autouav/finalproject/Reports/rep4/עמוד שער.docx

נווט אוטונומי

אוניברסיטת אריאל | http://www.ariel.ac.il/research/kcg

מנחה הפרויקט: ד"ר בועז בן משה

מגישים: נאור ידעי (302568894) יוסף זוהר (021512884)

אתר הפרויקט: https://github.com/autouav/finalproject

‏2015

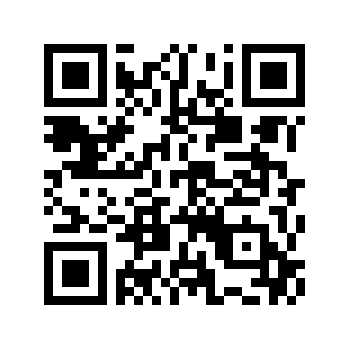
[picture p60: figure]
