autouav/finalproject/Reports/rep4/תרשים.docx

תרשים מס' 1: תרשים זה מתאר את המזל"ט בתחילת התהליך: המזל"ט במצב "קרקע". לאחר בדיקת תקינות המזל"ט עובר למצב "המתנה". הריבוע המסומן באדום הינו מעבר לתרשימים הבאים (2-3)

הפעלת
המזל"ט
חיבור המערכות:
Wifi, Bluetooth
ובדיקת תקינות
קיימת בעיה
מופיעה הודעה מתאימה על מסך הטלפון החכם
המערכת תקינה
ומחוברת כראוי
המזל"ט עולה לאוויר ובודק אם קיימת מטרה אחת או יותר
דוגמאות לבעיה:
בטריה חלשה
אין חיבור למטוס
לא התקבלה מטרה
המזל"ט נוחת במקום
התקבלה מטרה
המזל"ט מתכוונן אל המטרה בעזרת ומתחיל בנסיעה בקו ישר אל היעד

תרשים מס' 2: תרשים זה מתאר את המצב "טיסה אל היעד", בהנחה שלא קיימים מכשולים בין נקודת המוצא לבין נקודת היעד.

חשוב לשים לב: ייתכן שבשלב ראשון לא יהיו מכשולים בדרך, ולכן נעבוד לפי תרשים זה. אך בהמשך התרשים ישנם מצבים המחזירים אותנו לשלב "התקבלה מטרה", ושלב זה מתפצל לשניים: ללא מכשולים (תרשים זה), ועם מכשולים (תרשים 3, מובא להלן).

התקבלה מטרה
המזל"ט מתכוונן אל המטרה בעזרת ומתחיל בנסיעה בקו ישר אל היעד
אין מכשול
המזל"ט ממשיך בטיסה ישירה אל היעד
המזל"ט הגיע אל היעד
ממתין 5 שניות
המזל"ט לא הגיע אל היעד
תוך זמן קצוב ביחס למטרה
האלגוריתם יחזור לשלב
"התקבלה מטרה"
התקבלה מטרה נוספת
האלגוריתם יחזור לשלב
"התקבלה מטרה"
לא התקבלה מטרה נוספת
המטוס נוחת בנקודה

תרשים מס' 3: תרשים זה מתאר את המצב "סכנה" (מיידית / לא מיידית), ואת המצב "התגברות על מכשול".

חשוב לשים לב: ייתכן שבשלב ראשון נגיע למכשול, ולכן נעבוד לפי תרשים זה. אך בהמשך התרשים ישנם מצבים המחזירים אותנו לשלב "התקבלה מטרה", ושלב זה מתפצל לשניים: כולל מכשולים (תרשים זה), וללא מכשולים (תרשים 2, הובא לעיל).

התקבלה מטרה
המזל"ט מתכוונן אל המטרה בעזרת ומתחיל בנסיעה בקו ישר אל היעד
המטוס מתקרב למכשול
סכנה לא מיידית
המזל"ט עובר למצב
"עקיפת מכשול"
סכנה מיידית
המזל"ט נסוג לאחור
וממשיך באלגוריתם של
"סכנה לא מיידית"
אין מכשול
האלגוריתם יחזור לשלב
"התקבלה מטרה"
כל עוד קיים מכשול
המזל"ט טס ימינה ומשפר זווית ביחס למטרה עד שהמכשול נעלם מהסנסור הקידמי וממשיך באלגוריתם של "אין מכשול"
