autouav/finalproject/Reports/rep4/1.Still001.png

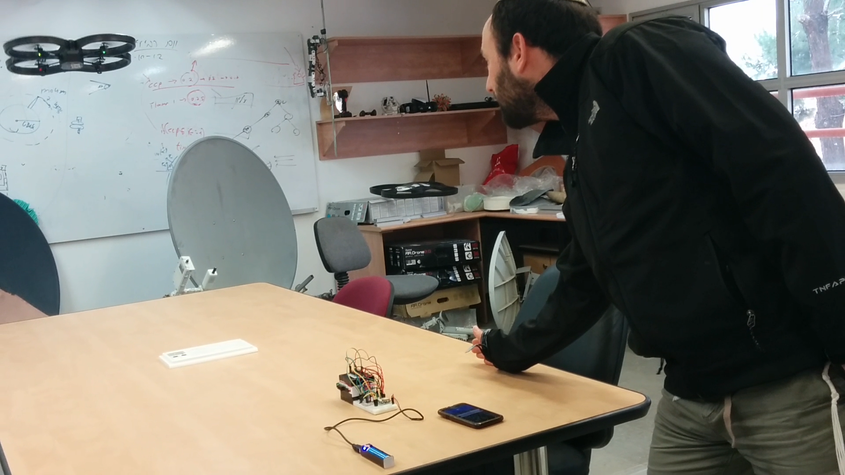
Reports/rep4/1.Still001.png
