autouav/finalproject/Reports/rep4/1.Still002.png

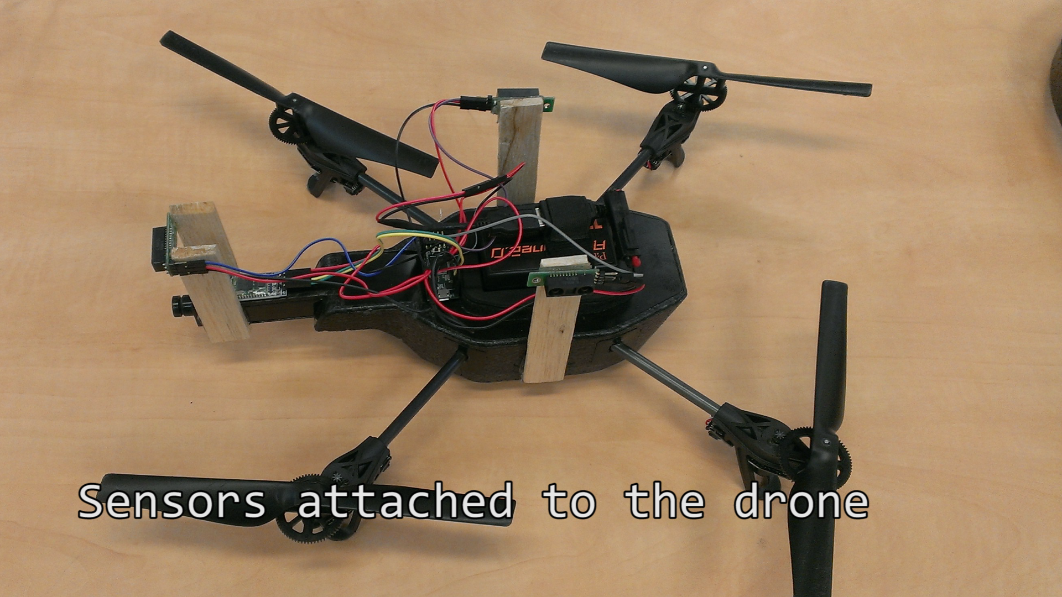
Reports/rep4/1.Still002.png
