autouav/finalproject/Reports/rep4/1.Still004.png

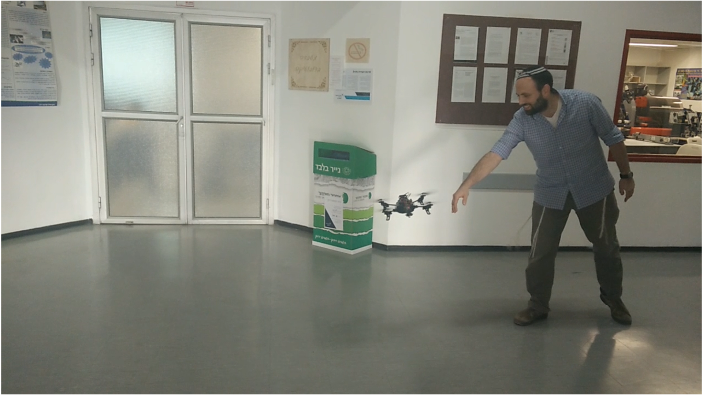
Reports/rep4/1.Still004.png
