autouav/finalproject/Reports/rep4/1.Still005.png

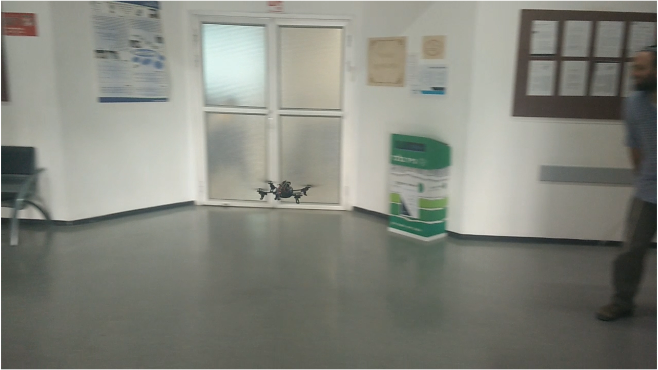
Reports/rep4/1.Still005.png
