autouav/finalproject/Reports/rep4/1.Still006.png

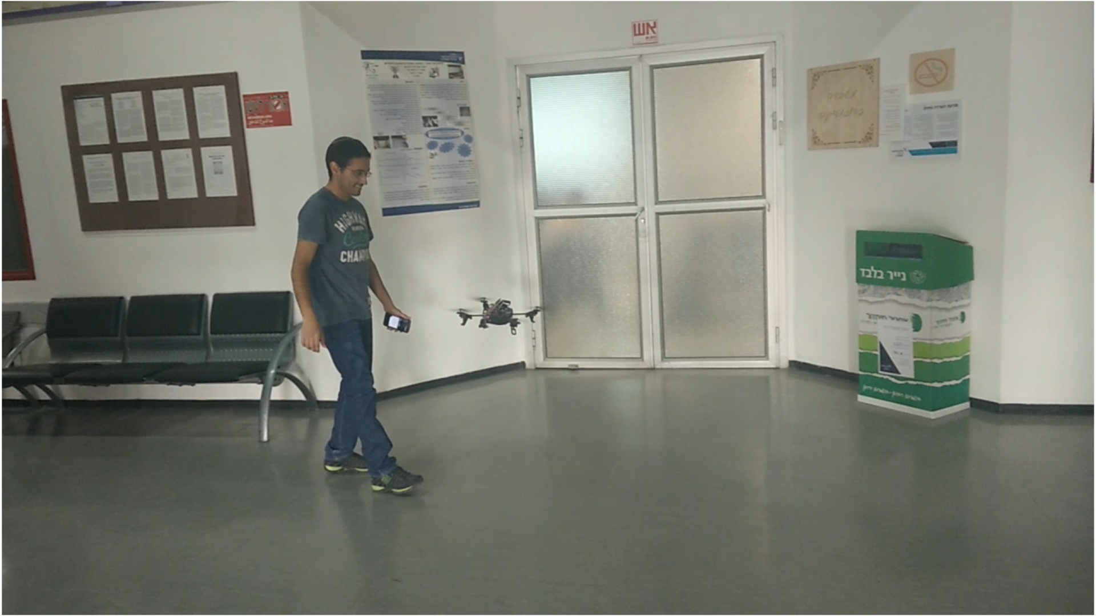
Reports/rep4/1.Still006.png
