autouav/finalproject/Reports/rep4/1.Still007.png

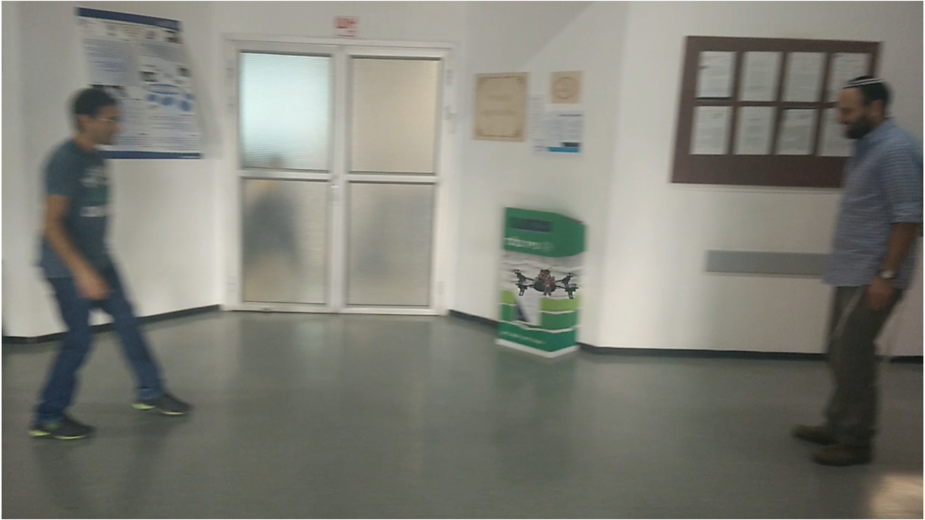
Reports/rep4/1.Still007.png
