autouav/finalproject/Reports/rep4/1.Still008.png

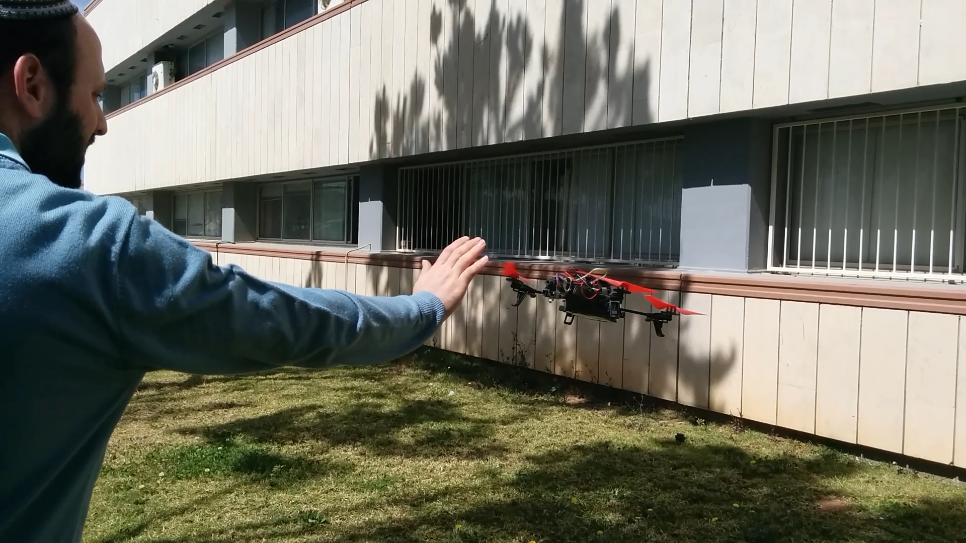
Reports/rep4/1.Still008.png
