autouav/finalproject/Reports/rep4/1.Still009.png

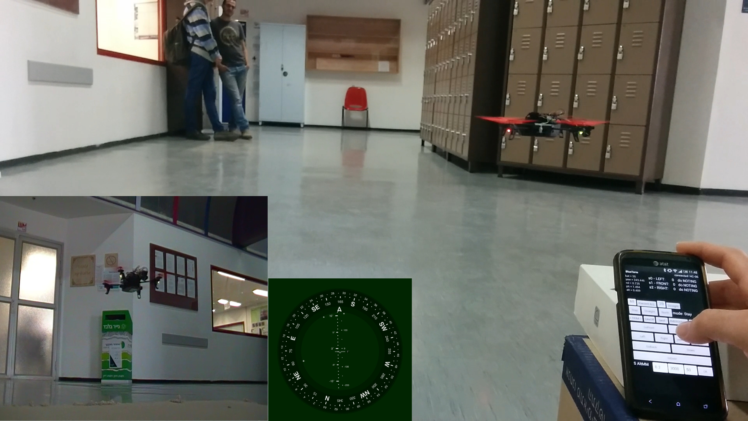
Reports/rep4/1.Still009.png
