autouav/finalproject/Reports/rep4/1.Still010.png

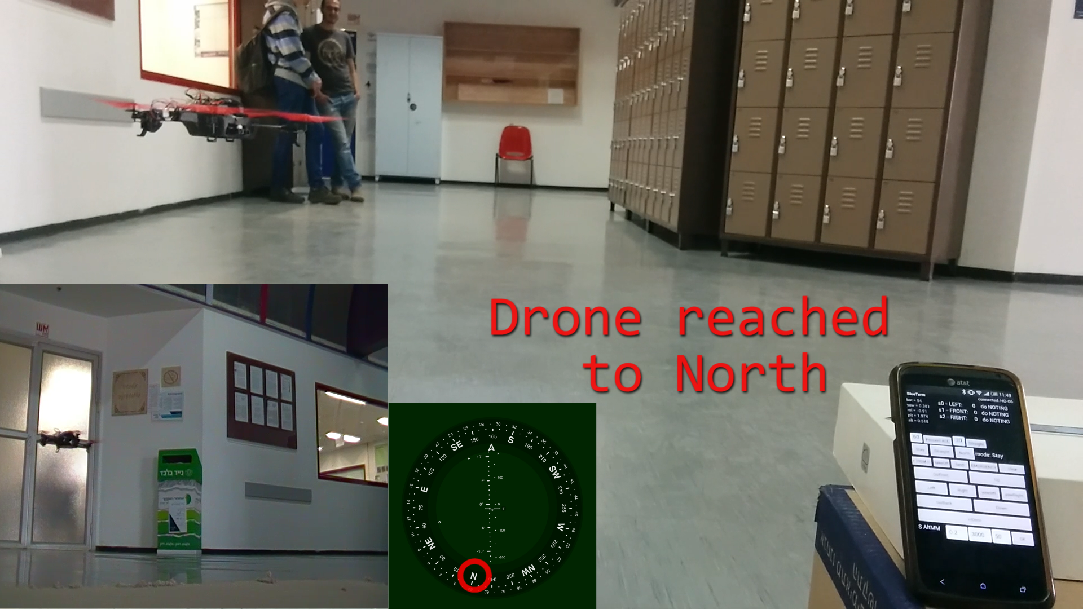
Reports/rep4/1.Still010.png
