autouav/finalproject/Reports/rep4/diagram2_bb.jpg

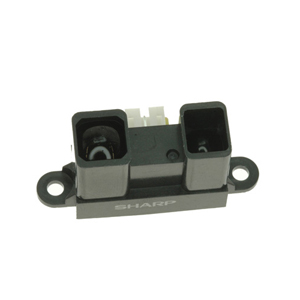
Reports/rep4/diagram2_bb.jpg
