autouav/finalproject/Reports/rep4/diagram.jpg

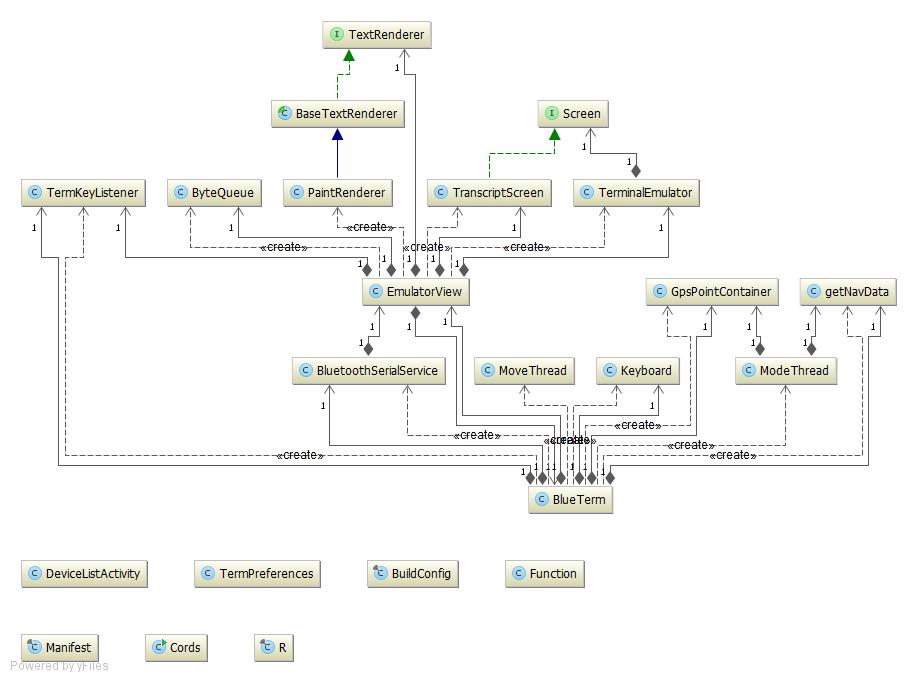
Reports/rep4/diagram.jpg
