autouav/finalproject/Reports/rep4/drone.jpg

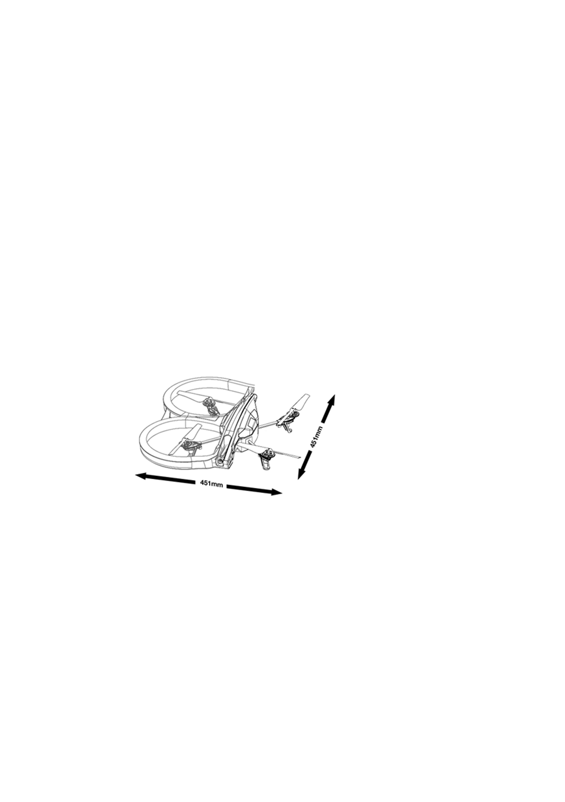
Reports/rep4/drone.jpg
