autouav/finalproject/Reports/rep4/Gyro.jpg

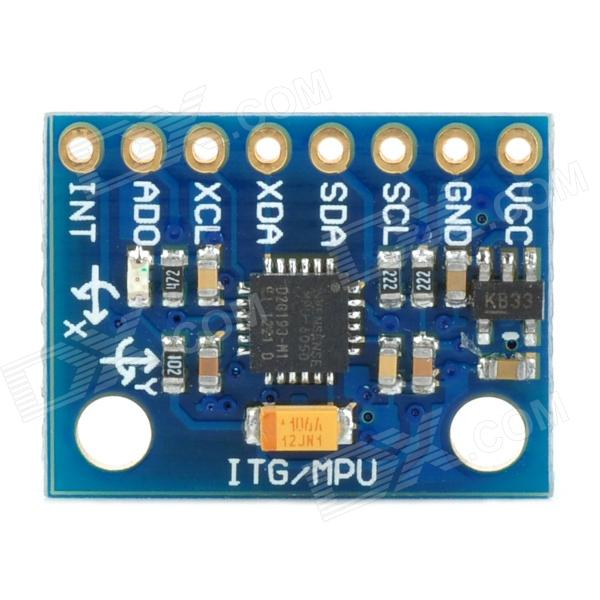
Reports/rep4/Gyro.jpg
