autouav/finalproject/Reports/rep4/IMG_20150111_101517.jpg

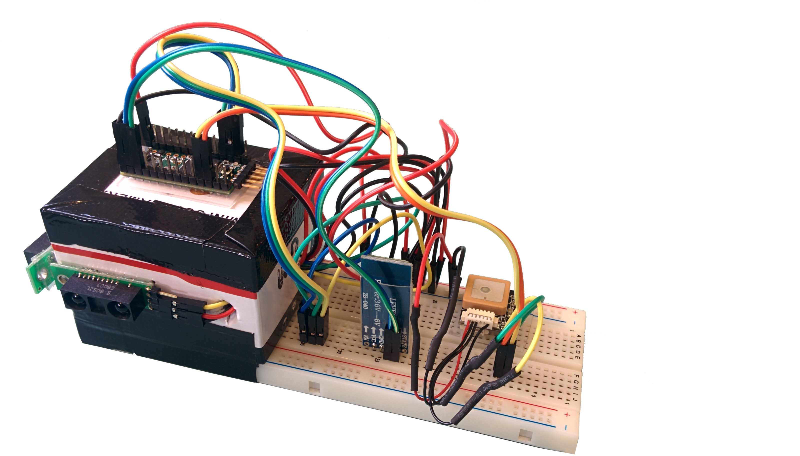
Reports/rep4/IMG_20150111_101517.jpg
