autouav/finalproject/Reports/rep4/Screenshot_2015-07-21-11-58-32.png

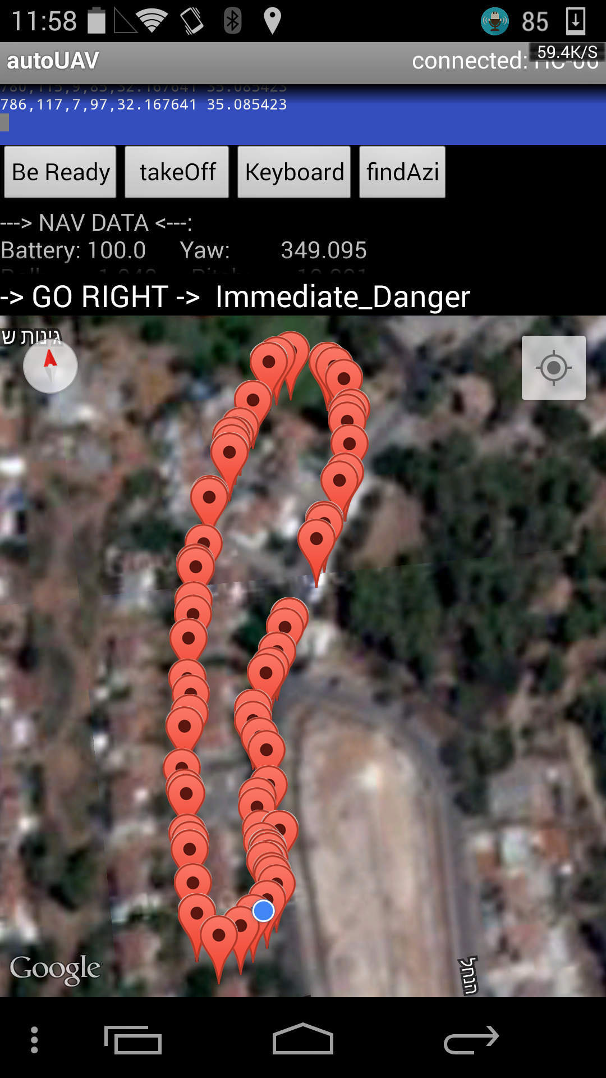
Reports/rep4/Screenshot_2015-07-21-11-58-32.png
