autouav/finalproject/Reports/rep4/Screenshot_2015-08-09-10-08-52.png

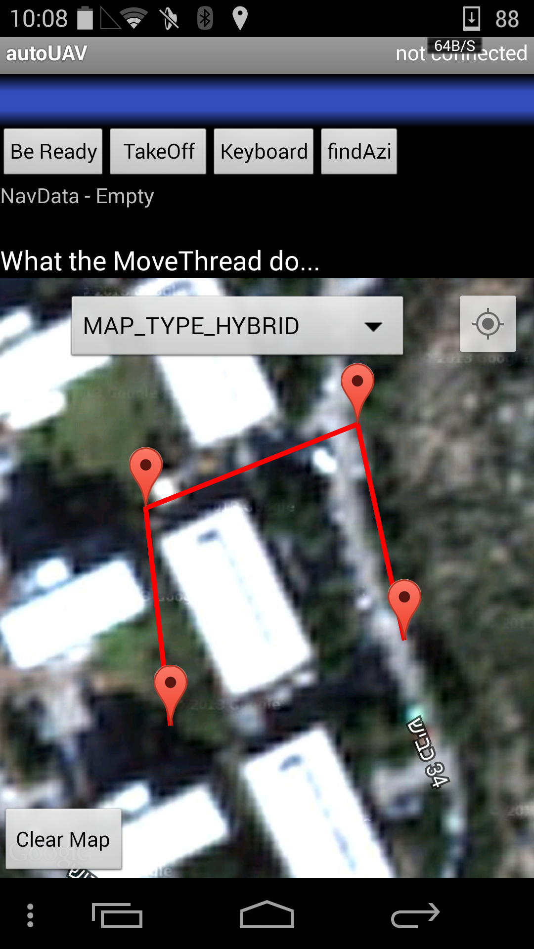
Reports/rep4/Screenshot_2015-08-09-10-08-52.png
