autouav/finalproject/Reports/rep4/Screenshot_2015-08-16-12-53-28.png

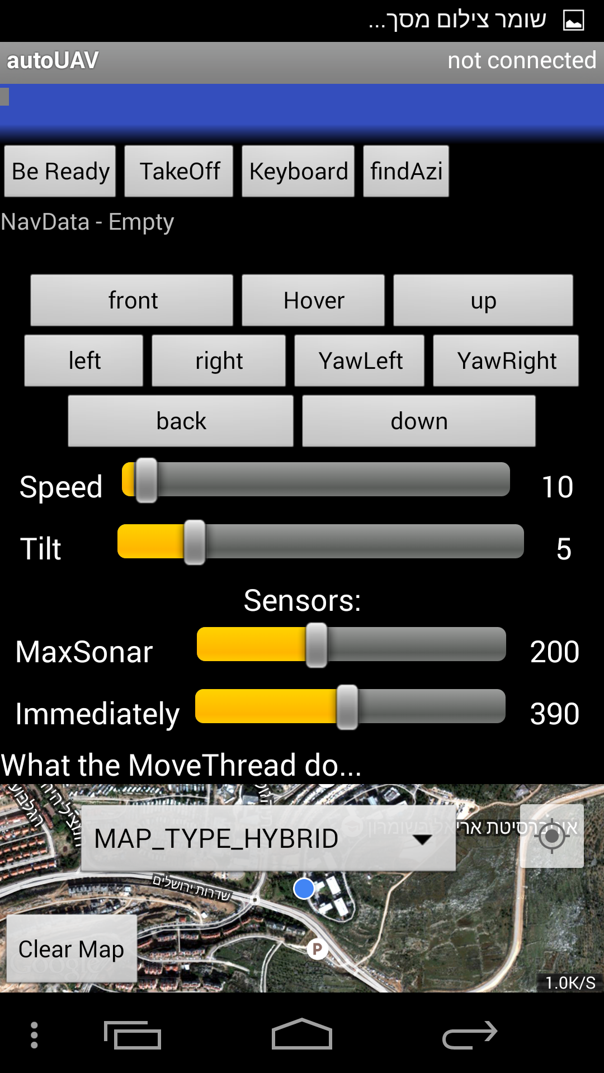
Reports/rep4/Screenshot_2015-08-16-12-53-28.png
