autouav/finalproject/Reports/rep4/Screenshot_2015-08-16-12-56-43.png

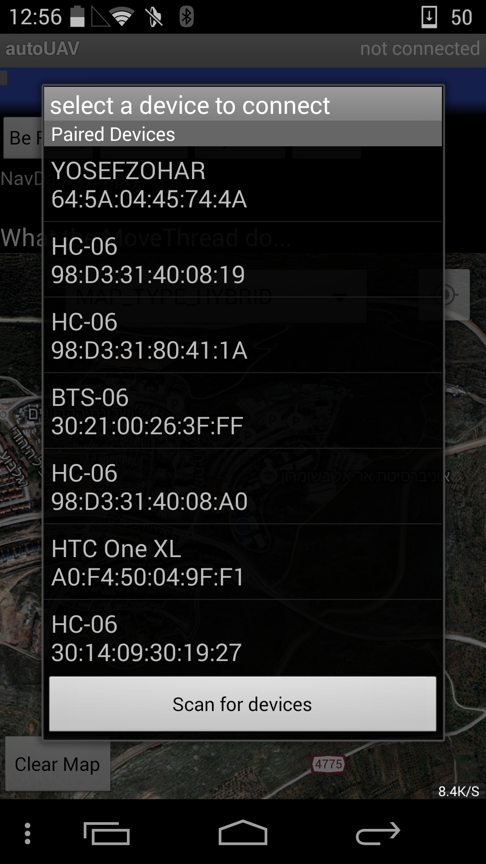
Reports/rep4/Screenshot_2015-08-16-12-56-43.png
