autouav/finalproject/Reports/rep4/Screenshot_2015-08-16-13-09-10.png

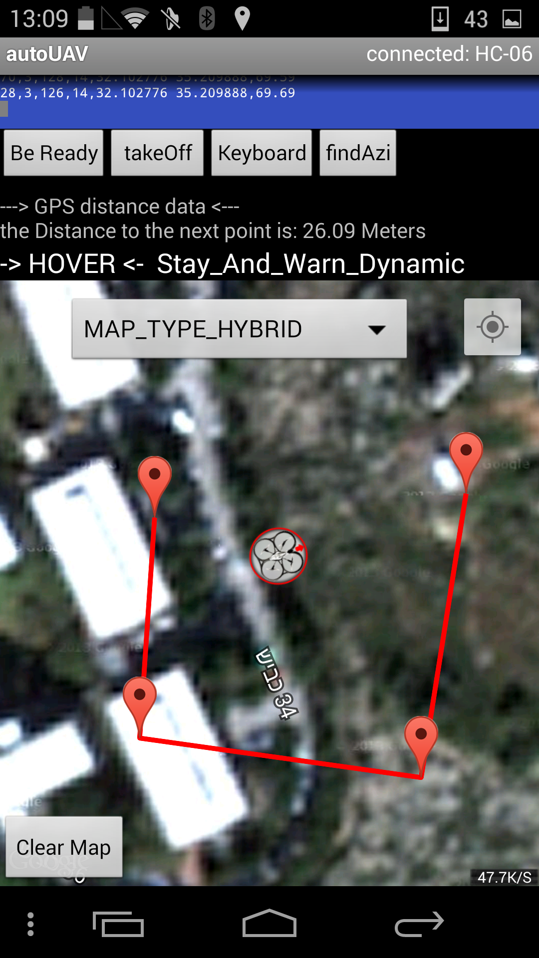
Reports/rep4/Screenshot_2015-08-16-13-09-10.png
