autouav/finalproject/Reports/rep4/sofi_bb.png

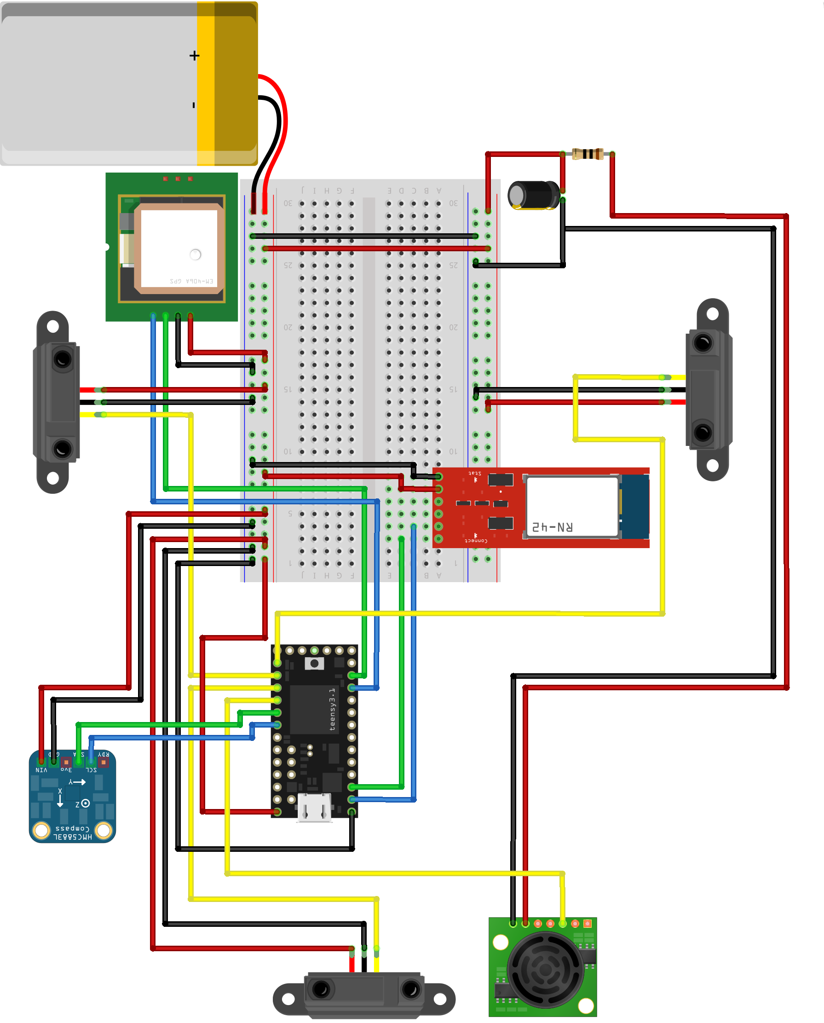
Reports/rep4/sofi_bb.png
