autouav/finalproject/Reports/rep4/use cases2.jpg

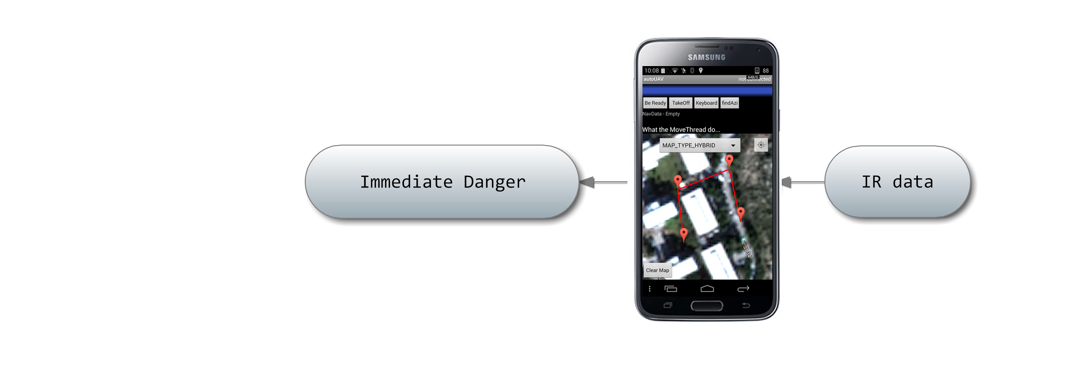
Reports/rep4/use cases2.jpg
