autouav/finalproject/Reports/rep4/use cases.jpg

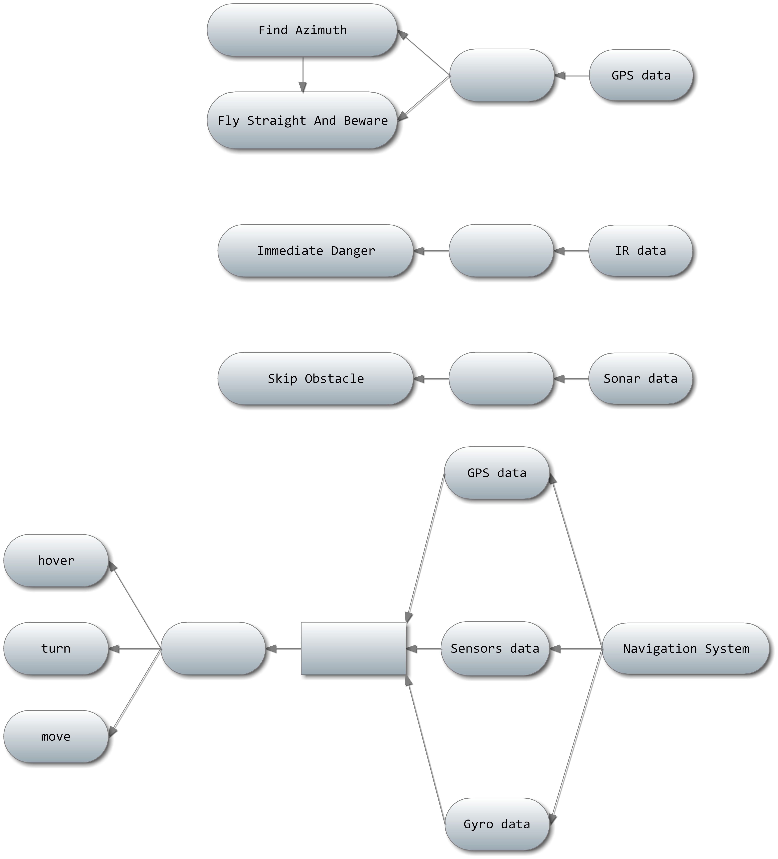
Reports/rep4/use cases.jpg
