autouav/finalproject/(commit log)

2015-07-12 add forth sensor (max sensor)
2015-07-19 adding the arduino files
2015-07-19 improve Teensy
2015-07-19 Add 3sensors + gps - arduino file
2015-07-19 update arduino file: sensors+GPS
2015-07-21 Add clear button
2015-07-28 Add Spinner button to replace map type
2015-08-02 new ino file - Gyro add
2015-08-02 Gyro final
2015-08-02 Change resource of Yaw parameter
2015-08-04 position from chip (yaw)
2015-08-04 change the init value of IR sensors
